Jamesrsh8/Heart-Rate-Monitor/project_photo.jpg

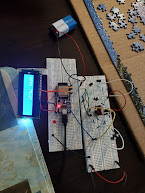
project_photo.jpg
