Jamesrsh8/Heart-Rate-Monitor/README.md

# Heart Rate Monitor

https://github.com/user-attachments/assets/fa03c80d-6e12-42cd-84a4-4755693d3de2

## How I made the project: Heart Rate Monitor Project.pdf

## Code: heartbeat_out.ino
