Jamesrsh8/Heart-Rate-Monitor/multisim_circuit.png

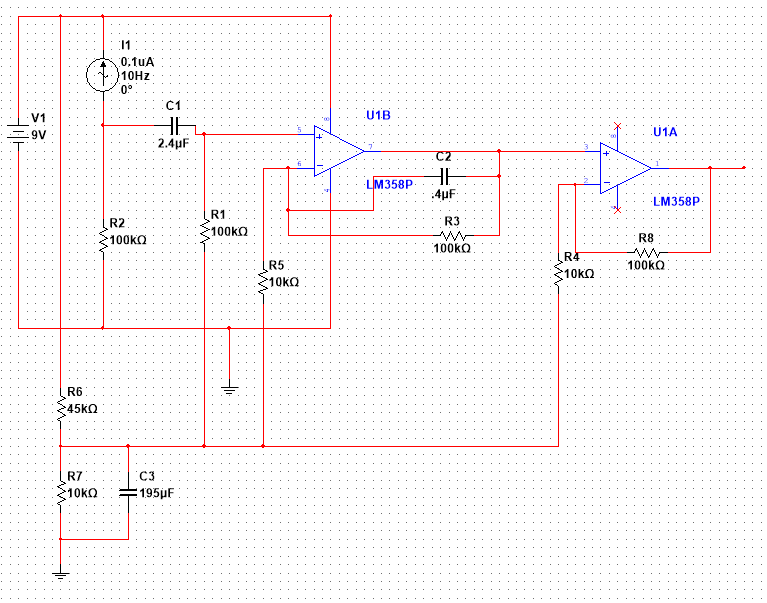
multisim_circuit.png
