Jamesrsh8/Heart-Rate-Monitor/Vout2.Vin.png

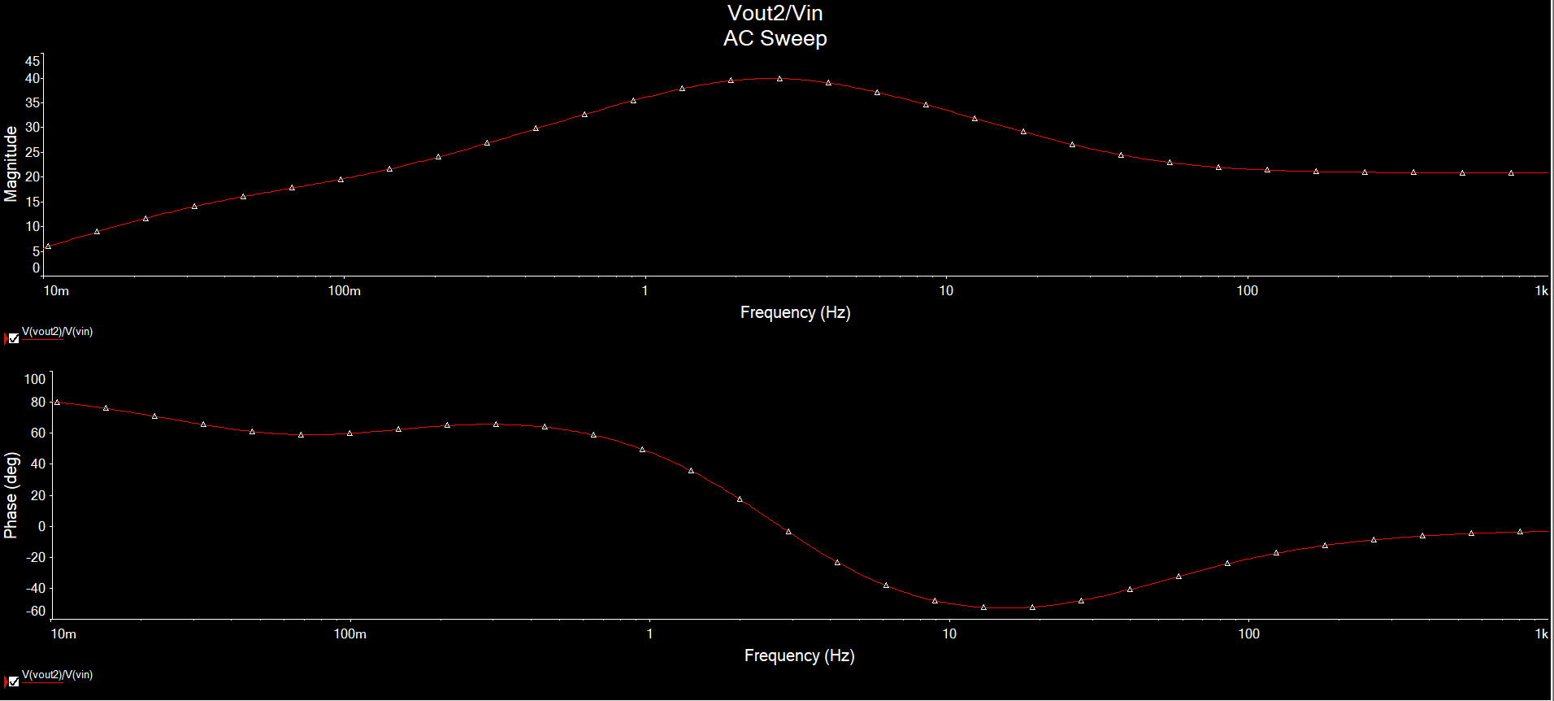
Vout2.Vin.png
